0BitsnBytes/mcqueen-pcb-file-for-kicanvas/Front view.png

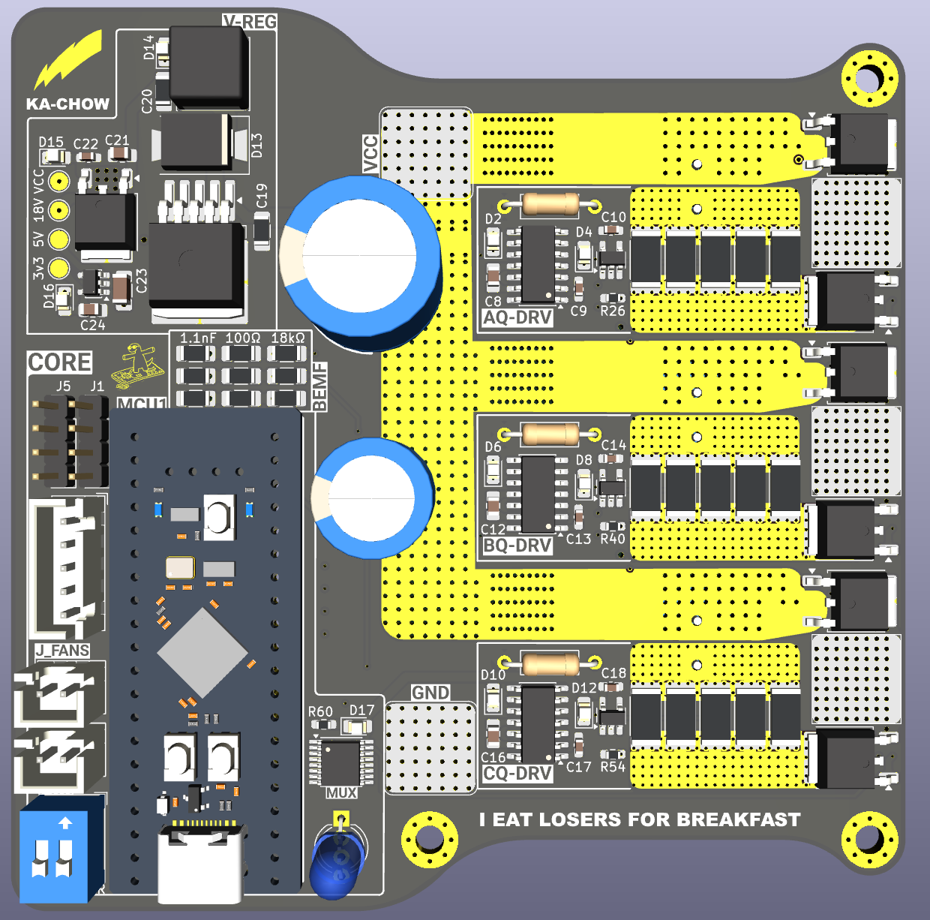
Front view.png
