0BitsnBytes/mcqueen-pcb-file-for-kicanvas/Back.png

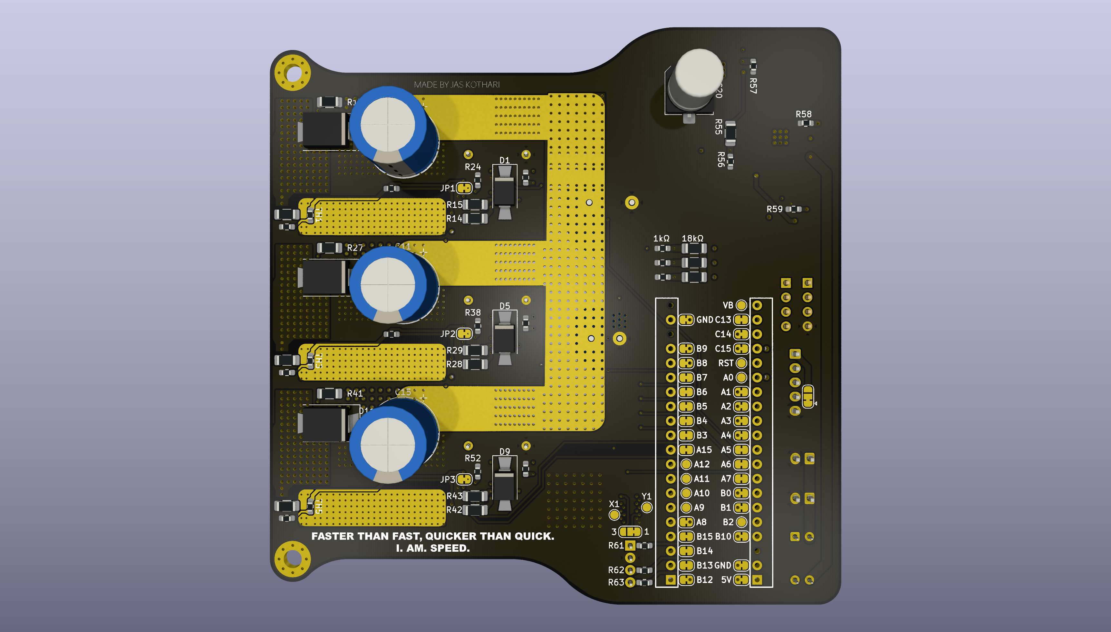
Back.png
