0BitsnBytes/mcqueen-pcb-file-for-kicanvas/Custom ESC.kicad_sch

## KiCad design Custom ESC.kicad_sch (2026-06-11)

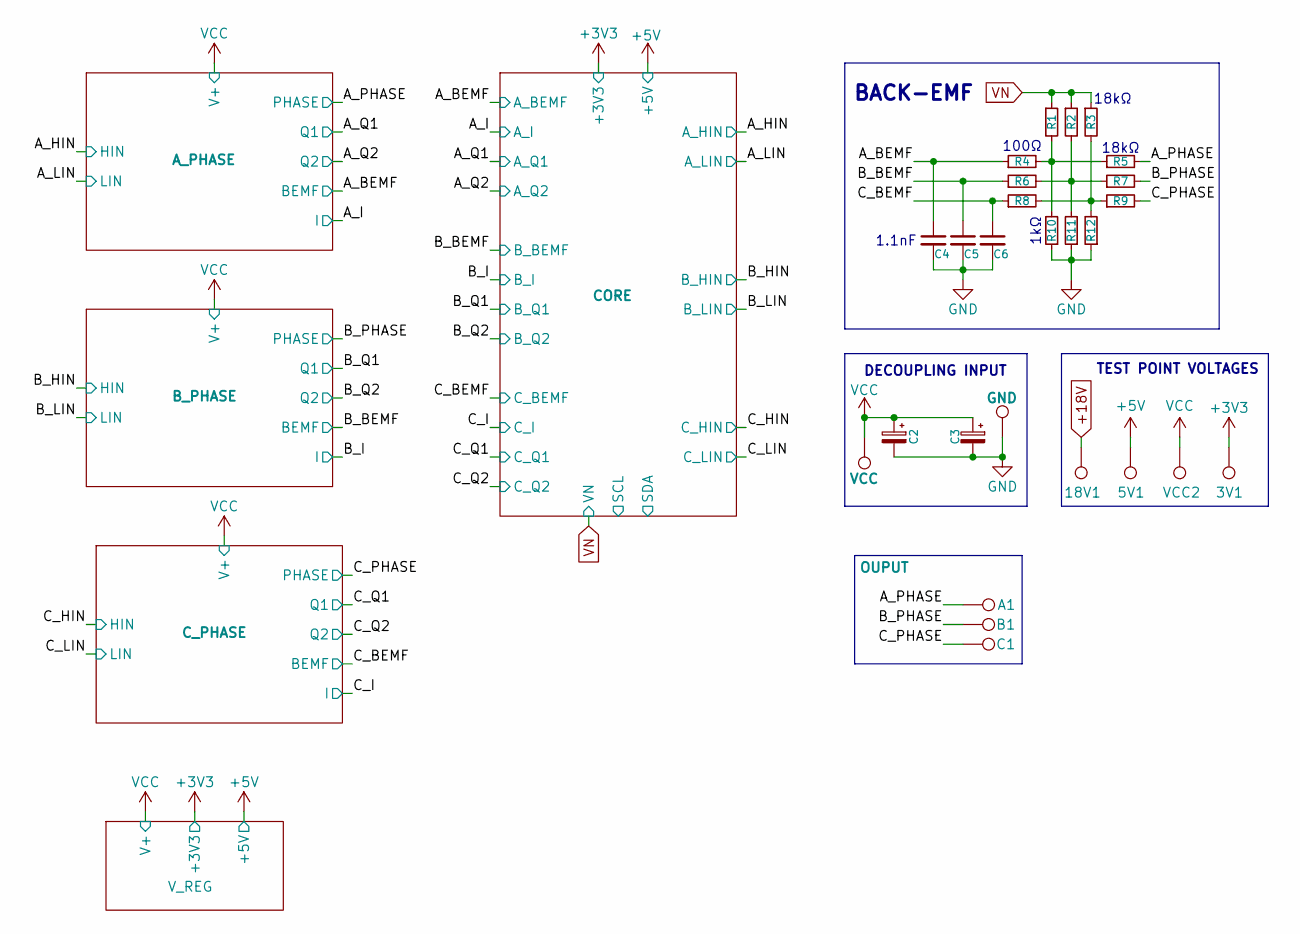
[picture p3: schematic Custom ESC.kicad_sch]

Parts:
3V1, 5V1, 18V1: TestPoint; TestPoint_Pad_D2.0mm
A1: OUPUT; 10x10
B1: OUPUT; 10x10
C1: OUPUT; 10x10
C2: 1000uf; CP_Radial_D16.0mm_P7.50mm
C3: 10uf; CP_Radial_D12.5mm_P5.00mm
C4, C5, C6: 1.1nF; R_1206_3216Metric_Pad1.30x1.75mm_HandSolder
GND1: GND; 10x10
R1, R2, R3, R5, R7, R9: 18kΩ; R_1206_3216Metric_Pad1.30x1.75mm_HandSolder
R4, R6, R8: 100Ω; R_1206_3216Metric_Pad1.30x1.75mm_HandSolder
R10, R11, R12: 1kΩ; R_0603_1608Metric_Pad0.98x0.95mm_HandSolder
VCC1: VCC; 10x10
VCC2: TestPoint; TestPoint_Pad_D2.0mm

Connections:
+3V3: 3V1.1
+5V: 5V1.1
+18V: 18V1.1
A_BEMF: C4.1, R4.1
A_PHASE: A1.1, R5.2
B_BEMF: C5.1, R6.1
B_PHASE: B1.1, R7.2
C_BEMF: C6.1, R8.1
C_PHASE: C1.1, R9.2
GND: C2.2, C3.2, C4.2, C5.2, C6.2, GND1.1, R10.1, R11.1, R12.1
unnamed: R1.2, R4.2, R5.1, R10.2
unnamed: R2.2, R6.2, R7.1, R11.2
unnamed: R3.2, R8.2, R9.1, R12.2
VCC: C2.1, C3.1, VCC1.1, VCC2.1
VN: R1.1, R2.1, R3.1

Notes on the sheet:
BACK-EMF
18kΩ
100Ω
1kΩ
1.1nF
TEST POINT VOLTAGES
DECOUPLING INPUT
