0BitsnBytes/mcqueen-pcb-file-for-kicanvas/PHASE_GENERATOR.kicad_sch

## KiCad design PHASE_GENERATOR.kicad_sch (2026-06-11)

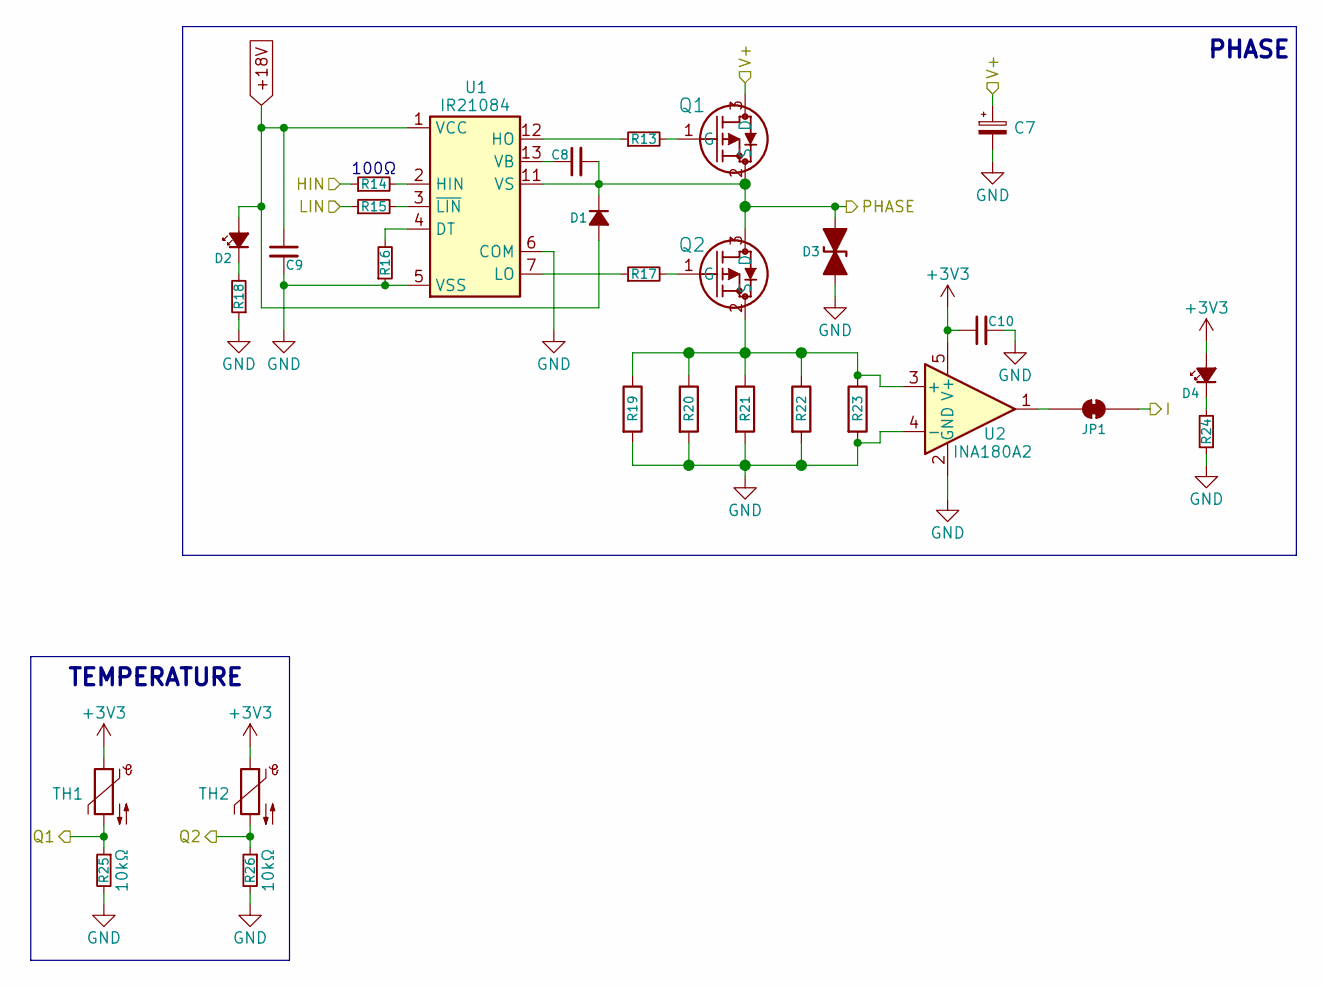
[picture p4: schematic PHASE_GENERATOR.kicad_sch]

Parts:
C7: C_Polarized_Small; CP_Radial_D12.5mm_P5.00mm
C8: 0.47uF; C_0805_2012Metric_Pad1.18x1.45mm_HandSolder
C9, C10: 0.1uF; C_0603_1608Metric_Pad1.08x0.95mm_HandSolder
D1: ES1C; D_SMA-SMB_Universal_Handsoldering
D2, D4: LED_Small_Filled; LED_0805_2012Metric_Pad1.15x1.40mm_HandSolder
D3: D_TVS_Filled; D_SMB-SMC_Universal_Handsoldering
JP1: SolderJumper_2_Bridged; SolderJumper-2_P1.3mm_Bridged_RoundedPad1.0x1.5mm
Q1, Q2: DMT10H009LK3-13; TO-252-2
R13, R17: 10Ω; R_1206_3216Metric_Pad1.30x1.75mm_HandSolder
R14, R15: 100Ω; R_1206_3216Metric_Pad1.30x1.75mm_HandSolder
R16: THT; R_Axial_DIN0207_L6.3mm_D2.5mm_P10.16mm_Horizontal
R18, R24: 330Ω; R_0603_1608Metric_Pad0.98x0.95mm_HandSolder
R19, R20, R21, R22, R23: 5mΩ; R_2512_6332Metric_Pad1.40x3.35mm_HandSolder
R25, R26: 10kΩ; R_0603_1608Metric_Pad0.98x0.95mm_HandSolder
TH1, TH2: NCU18XH103F6SRB; R_0603_1608Metric_Pad0.98x0.95mm_HandSolder
U1: IR21084; SOIC-14_3.9x8.7mm_P1.27mm
U2: INA180A2; SOT-23-5_HandSoldering

Connections:
+3V3: C10.1, D4.2 (A), TH1.1, TH2.1, U2.5 (V+)
+18V: C9.1, D1.2 (A), D2.2 (A), U1.1 (VCC)
GND: C7.2, C9.2, C10.2, D3.1 (A1), R16.1, R18.1, R19.2, R20.2, R21.2, R22.2, R23.2, R24.1, R25.2, R26.2, U1.5 (VSS), U1.6 (COM), U2.2 (GND), U2.4 (-)
HIN: R14.1
I: JP1.2 (B)
LIN: R15.1
unnamed: C8.1, U1.13 (VB)
unnamed: D2.1 (K), R18.2
unnamed: D4.1 (K), R24.2
unnamed: JP1.1 (A), U2.1
unnamed: Q1.1 (G), R13.2
unnamed: Q2.1 (G), R17.2
unnamed: Q2.2 (S), R19.1, R20.1, R21.1, R22.1, R23.1, U2.3 (+)
unnamed: R13.1, U1.12 (HO)
unnamed: R14.2, U1.2 (HIN)
unnamed: R15.2, U1.3 (~LIN)
unnamed: R16.2, U1.4 (DT)
unnamed: R17.1, U1.7 (LO)
PHASE: C8.2, D1.1 (K), D3.2 (A2), Q1.2 (S), Q2.3 (D), U1.11 (VS)
Q1: R25.1, TH1.2
Q2: R26.1, TH2.2
V+: C7.1, Q1.3 (D)

Notes on the sheet:
TEMPERATURE
100Ω
PHASE
