0BitsnBytes/mcqueen-pcb-file-for-kicanvas/core.kicad_sch

## KiCad design core.kicad_sch (2026-06-11)

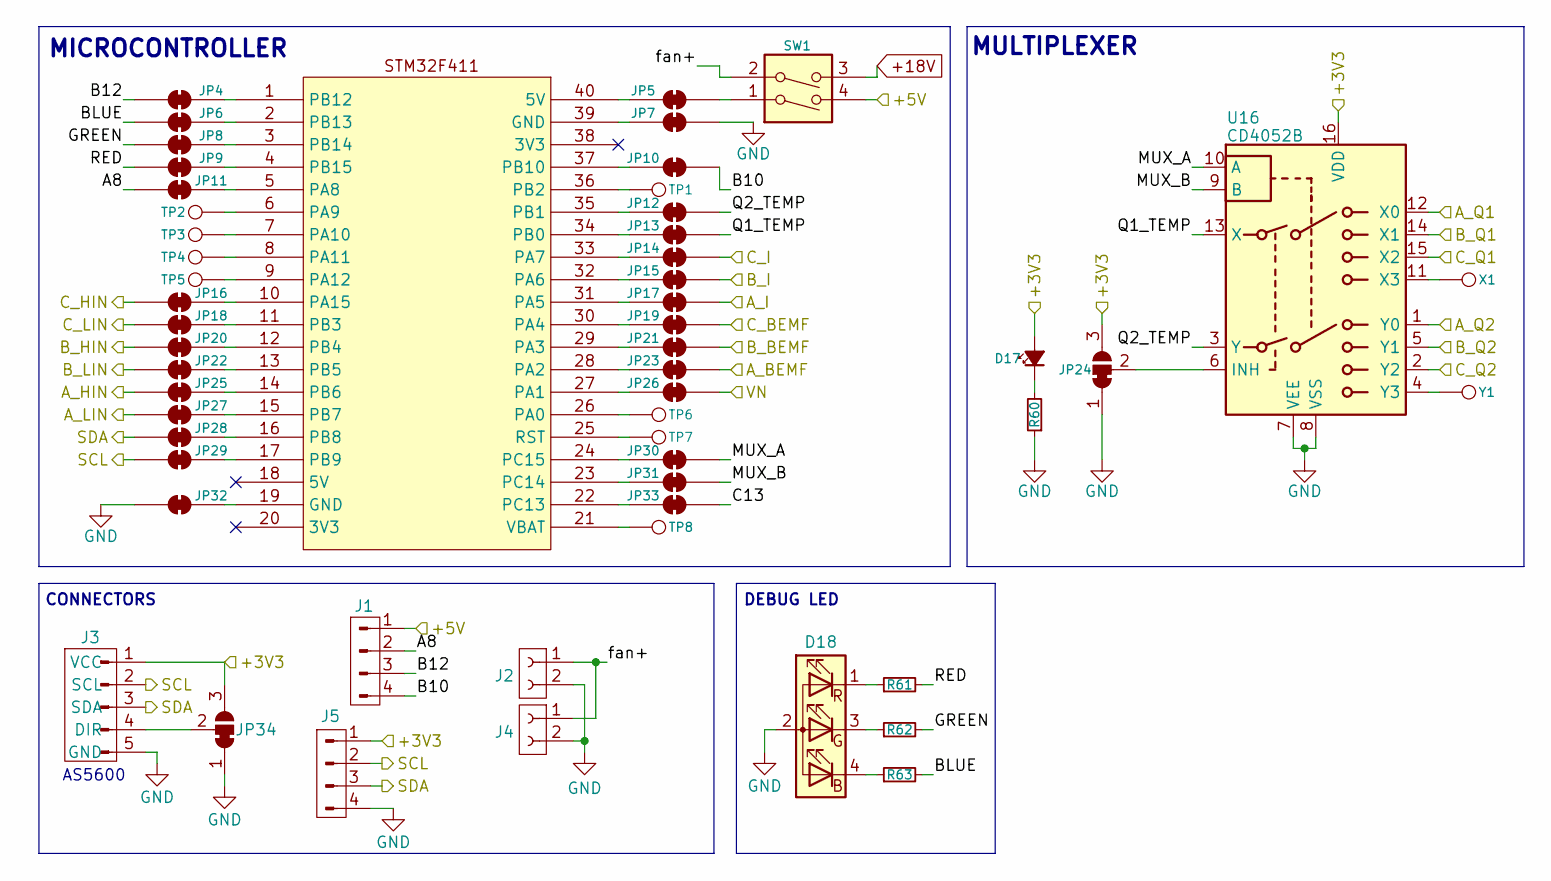
[picture p5: schematic core.kicad_sch]

Parts:
D17: LED_Small_Filled; LED_0805_2012Metric_Pad1.15x1.40mm_HandSolder
D18: LED_RAGB; LED_D5.0mm-4_RGB_Wide_Pins
J1, J5: Conn_01x04_Pin; PinHeader_1x04_P2.54mm_Vertical
J2, J4: Conn_01x02_Socket; JST_XH_B2B-XH-A_1x02_P2.50mm_Vertical
J3: Conn_01x05_Pin; JST_XH_B5B-XH-A_1x05_P2.50mm_Vertical
JP4, JP5, JP6, JP7, JP8, JP9, JP10, JP11, JP12, JP13, JP14, JP15, JP16, JP17, JP18, JP19, JP20, JP21, JP22, JP23, JP25, JP26, JP27, JP28, JP29, JP30, JP31, JP32, JP33: SolderJumper_2_Bridged; SolderJumper-2_P1.3mm_Bridged_RoundedPad1.0x1.5mm
JP24: SolderJumper_3_Bridged12; SolderJumper-3_P1.3mm_Bridged12_RoundedPad1.0x1.5mm_NumberL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
JP34: SolderJumper_3_Bridged12; SolderJumper-3_P1.3mm_Bridged12_RoundedPad1.0x1.5mm
MCU1: U?; STM32F4x1CxU6 WeActStudio
R60, R61: 330Ω; R_0603_1608Metric_Pad0.98x0.95mm_HandSolder
R62: 470Ω; R_0603_1608Metric_Pad0.98x0.95mm_HandSolder
R63: 47Ω; R_0603_1608Metric_Pad0.98x0.95mm_HandSolder
SW1: SW_DIP_x02; SW_DIP_SPSTx02_Slide_9.78x7.26mm_W7.62mm_P2.54mm
TP1, TP2, TP3, TP4, TP5, TP6, TP7, TP8: TestPoint; TestPoint_Pad_D1.5mm
U16: CD4052B; TSSOP-16_4.4x5mm_P0.65mm
X1: TestPoint; TestPoint_Pad_D1.5mm
Y1: TestPoint; TestPoint_Pad_D1.5mm

Connections:
+3V3: D17.2 (A), J3.1 (VCC), J5.1, JP24.3 (B), JP34.3 (B), U16.16 (VDD)
+5V: J1.1, SW1.4
+18V: SW1.3
A8: J1.2, JP11.1 (A)
A_BEMF: JP23.1 (A)
A_HIN: JP25.1 (A)
A_I: JP17.1 (A)
A_LIN: JP27.1 (A)
A_Q1: U16.12 (X0)
A_Q2: U16.1 (Y0)
B10: J1.4, JP10.1 (A)
B12: J1.3, JP4.1 (A)
BLUE: JP6.1 (A), R63.2
B_BEMF: JP21.1 (A)
B_HIN: JP20.1 (A)
B_I: JP15.1 (A)
B_LIN: JP22.1 (A)
B_Q1: U16.14 (X1)
B_Q2: U16.5 (Y1)
C13: JP33.1 (A)
C_BEMF: JP19.1 (A)
C_HIN: JP16.1 (A)
C_I: JP14.1 (A)
C_LIN: JP18.1 (A)
C_Q1: U16.15 (X2)
C_Q2: U16.2 (Y2)
GND: D18.2 (A), J2.2 (GND), J3.5 (GND), J4.2 (GND), J5.4, JP7.1 (A), JP24.1 (A), JP32.1 (A), JP34.1 (A), R60.1, U16.7 (VEE), U16.8 (VSS)
GREEN: JP8.1 (A), R62.2
MUX_A: JP30.1 (A), U16.10 (A)
MUX_B: JP31.1 (A), U16.9 (B)
unnamed: D17.1 (K), R60.2
unnamed: D18.1 (RK), R61.1
unnamed: D18.3 (GK), R62.1
unnamed: D18.4 (BK), R63.1
unnamed: J3.4 (DIR), JP34.2 (C)
unnamed: JP4.2 (B), MCU1.1 (PB12)
unnamed: JP5.1 (A), SW1.1
unnamed: JP5.2 (B), MCU1.40 (5V)
unnamed: JP6.2 (B), MCU1.2 (PB13)
unnamed: JP7.2 (B), MCU1.39 (GND)
unnamed: JP8.2 (B), MCU1.3 (PB14)
unnamed: JP9.2 (B), MCU1.4 (PB15)
unnamed: JP10.2 (B), MCU1.37 (PB10)
unnamed: JP11.2 (B), MCU1.5 (PA8)
unnamed: JP12.2 (B), MCU1.35 (PB1)
unnamed: JP13.2 (B), MCU1.34 (PB0)
unnamed: JP14.2 (B), MCU1.33 (PA7)
unnamed: JP15.2 (B), MCU1.32 (PA6)
unnamed: JP16.2 (B), MCU1.10 (PA15)
unnamed: JP17.2 (B), MCU1.31 (PA5)
unnamed: JP18.2 (B), MCU1.11 (PB3)
unnamed: JP19.2 (B), MCU1.30 (PA4)
unnamed: JP20.2 (B), MCU1.12 (PB4)
unnamed: JP21.2 (B), MCU1.29 (PA3)
unnamed: JP22.2 (B), MCU1.13 (PB5)
unnamed: JP23.2 (B), MCU1.28 (PA2)
unnamed: JP24.2 (C), U16.6 (INH)
unnamed: JP25.2 (B), MCU1.14 (PB6)
unnamed: JP26.2 (B), MCU1.27 (PA1)
unnamed: JP27.2 (B), MCU1.15 (PB7)
unnamed: JP28.2 (B), MCU1.16 (PB8)
unnamed: JP29.2 (B), MCU1.17 (PB9)
unnamed: JP30.2 (B), MCU1.24 (PC15)
unnamed: JP31.2 (B), MCU1.23 (PC14)
unnamed: JP32.2 (B), MCU1.19 (GND)
unnamed: JP33.2 (B), MCU1.22 (PC13)
unnamed: MCU1.6 (PA9), TP2.1
unnamed: MCU1.7 (PA10), TP3.1
unnamed: MCU1.8 (PA11), TP4.1
unnamed: MCU1.9 (PA12), TP5.1
unnamed: MCU1.21 (VBAT), TP8.1
unnamed: MCU1.25 (RST), TP7.1
unnamed: MCU1.26 (PA0), TP6.1
unnamed: MCU1.36 (PB2), TP1.1
unnamed: U16.4 (Y3), Y1.1
unnamed: U16.11 (X3), X1.1
Q1_TEMP: JP13.1 (A), U16.13 (X)
Q2_TEMP: JP12.1 (A), U16.3 (Y)
RED: JP9.1 (A), R61.2
SCL: J3.2 (SCL), J5.2, JP29.1 (A)
SDA: J3.3 (SDA), J5.3, JP28.1 (A)
VN: JP26.1 (A)
fan+: J2.1 (V+), J4.1 (V+), SW1.2

Notes on the sheet:
DEBUG LED
MULTIPLEXER
CONNECTORS
AS5600
MICROCONTROLLER
