0BitsnBytes/mcqueen-pcb-file-for-kicanvas/v_reg.kicad_sch

## KiCad design v_reg.kicad_sch (2026-06-13)

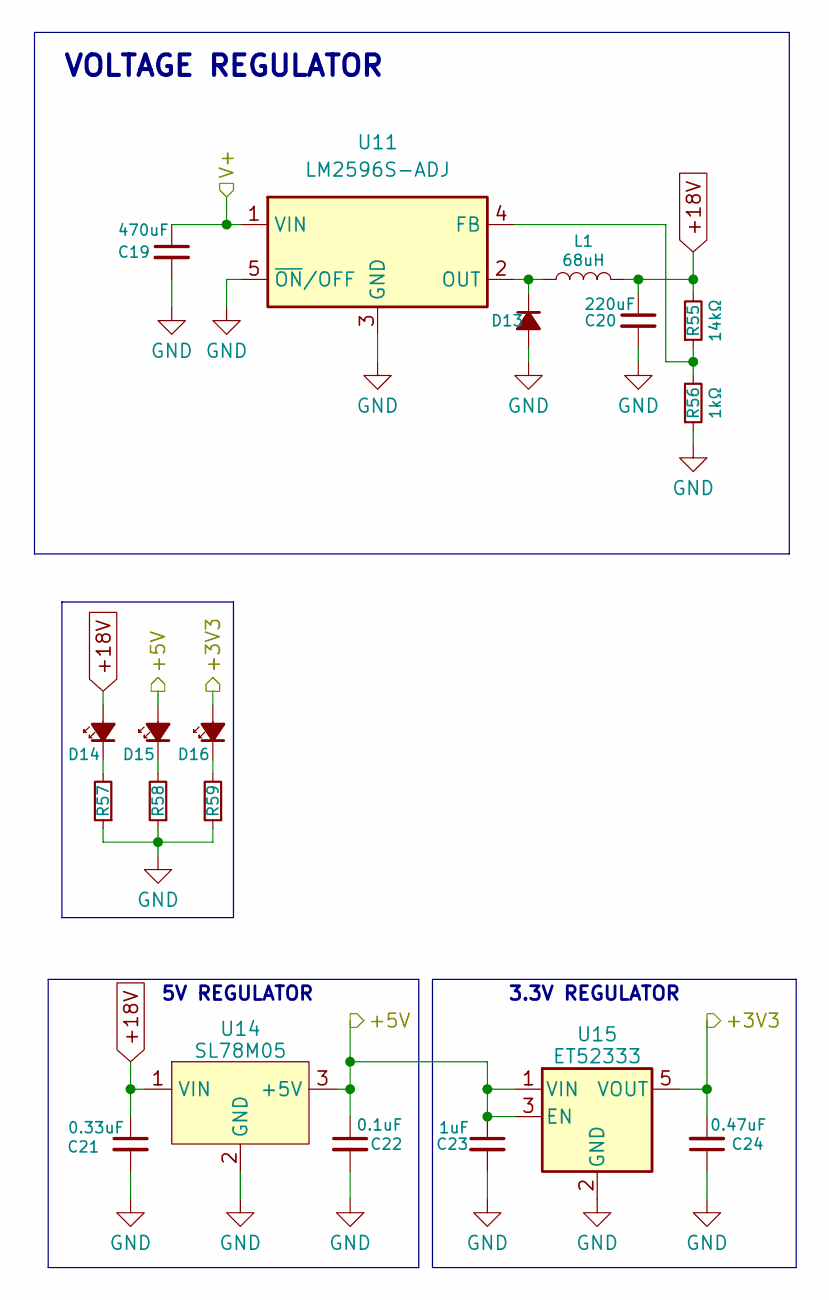
[picture p6: schematic v_reg.kicad_sch]

Parts:
C19: 470uF; R_1206_3216Metric_Pad1.30x1.75mm_HandSolder
C20: 220uF; C_Elec_8x10.2
C21: 0.33uF; C_0805_2012Metric_Pad1.18x1.45mm_HandSolder
C22: 0.1uF; C_0603_1608Metric_Pad1.08x0.95mm_HandSolder
C23: 1uF; C_1206_3216Metric_Pad1.33x1.80mm_HandSolder
C24: 0.47uF; C_0805_2012Metric_Pad1.18x1.45mm_HandSolder
D13: SS34; D_SMB-SMC_Universal_Handsoldering
D14, D15, D16: LED_Small_Filled; LED_0805_2012Metric_Pad1.15x1.40mm_HandSolder
L1: 68uH; L_Changjiang_FNR8040S
R55: 14kΩ; R_1206_3216Metric_Pad1.30x1.75mm_HandSolder
R56: 1kΩ; R_0603_1608Metric_Pad0.98x0.95mm_HandSolder
R57, R58, R59: 330Ω; R_0603_1608Metric_Pad0.98x0.95mm_HandSolder
U11: LM2596S-ADJ; TO-263-5_TabPin3
U14: SL78M05; TO-252-2
U15: ET52333; SOT-23-5

Connections:
+3V3: C24.2, D16.2 (A), U15.5 (VOUT)
+5V: C22.1, C23.1, D15.2 (A), U14.3 (+5V), U15.1 (VIN), U15.3 (EN)
+18V: C20.1, C21.1, D14.2 (A), L1.2, R55.2, U14.1 (VIN)
GND: C19.2, C20.2, C21.2, C22.2, C23.2, C24.1, D13.2 (A), R56.1, R57.1, R58.1, R59.1, U11.3 (GND), U11.5 (~ON/OFF), U14.2 (GND), U15.2 (GND)
unnamed: D13.1 (K), L1.1, U11.2 (OUT)
unnamed: D14.1 (K), R57.2
unnamed: D15.1 (K), R58.2
unnamed: D16.1 (K), R59.2
unnamed: R55.1, R56.2, U11.4 (FB)
V+: C19.1, U11.1 (VIN)

Notes on the sheet:
VOLTAGE REGULATOR
5V REGULATOR
3.3V REGULATOR
