0BitsnBytes/mcqueen-pcb-file-for-kicanvas/(commit log)

2026-06-12 changed files
    [Custom ESC-B_Cu.gbl, Custom ESC-B_Mask.gbs, Custom ESC-B_Paste.gbp, Custom ESC-B_Silkscreen.gbo, Custom ESC-Edge_Cuts.gm1, Custom ESC-F_Cu.gtl, Custom ESC-F_Mask.gts, Custom ESC-F_Paste.gtp]
2026-06-12 redo files
    [Custom ESC-B_Cu.gbl, Custom ESC-B_Mask.gbs, Custom ESC-B_Paste.gbp, Custom ESC-B_Silkscreen.gbo, Custom ESC-Edge_Cuts.gm1, Custom ESC-F_Cu.gtl, Custom ESC-F_Mask.gts, Custom ESC-F_Paste.gtp]
2026-06-13 redo gerber
    [Custom ESC-B_Cu.gbl, Custom ESC-B_Mask.gbs, Custom ESC-B_Paste.gbp, Custom ESC-B_Silkscreen.gbo, Custom ESC-Edge_Cuts.gm1, Custom ESC-F_Cu.gtl, Custom ESC-F_Mask.gts, Custom ESC-F_Paste.gtp]
2026-06-13 redo github
    [Custom ESC-B_Cu.gbl, Custom ESC-B_Mask.gbs, Custom ESC-B_Paste.gbp, Custom ESC-B_Silkscreen.gbo, Custom ESC-Edge_Cuts.gm1, Custom ESC-F_Cu.gtl, Custom ESC-F_Mask.gts, Custom ESC-F_Paste.gtp]
